marcovanzetto/esp32-mfcc-sound-recognition/(commit log)

2026-11-04 Initial commit: MFCC-based real-time sound recognition for ESP32
    - ESP32 sketch: learning phase (reference MFCC matrix + adaptive
    distance threshold) and real-time monitoring via sliding-window
    Frobenius distance
    - README with method, wiring, setup, configuration and results
    - MIT license
2026-11-05 Add a cancel command and clarify the README
    - Send 'C' to cancel the learning or stop the monitoring: stage 1 no
    longer waits forever if the sound never exceeds the RMS threshold
    - README: GPIO 15 is a strapping pin, suggest GPIO 34 for new builds
    - README: scope of the false-positive claim, academic year
